patrick-groeppner/Track_your_cat_GPS-tracker/README.md

# Track_your_cat_GPS-tracker
project files for the development of a gps tracker for the offline movement tracking of your beloved home cat. Can also be used for other tracking purposes like car movement recordings or the measurement of walking routs
