patrick-groeppner/Track_your_cat_GPS-tracker/_Abschlussbericht Track-your-cat/Datenblatt des Produktes Track your Cat.pdf

## „Track your Cat“ - GPS-Empfänger

### 1 Merkmale

- Keine monatlichen Gebühren
- Kleine Dimensionierung
- Lange Batterielaufzeit
- Plug & Play
- Einfach zu verwendendes
Gerät
- Datenformat passend für
Google Earth
- Niedriges Gewicht
- Entlastend für Haustiere
- Gehäuse passend für gängige Halsbänder
- Micro-SD Karte
- günstiger Speicher

### 2 Aufbau

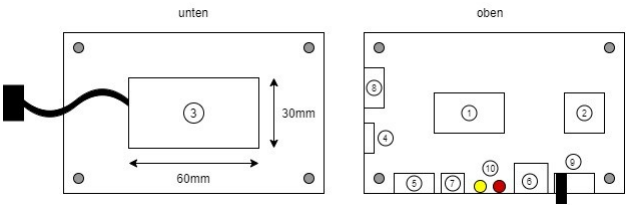
[picture p16: figure]

1: 8-bit Mikrokontroller
2: GPS Empfangschip
3: 3,7V Lithium Polymer Batterie 4: Thermistor Anschluss
5: Micro USB-Stecker

### 3 Beschreibung

Das „Track your Cat“ ist ein GPS-Empfangsgerät basierend auf einen 8-bit Mikrocontroller von Atmel mit wiederaufladbarem Akku. Als Receiver Chip wird der ORG1410 von OriginGPS verwendet. Es besteht aus einer kompakten Hauptplatine und ist in einem 3Dgedrucktes Gehäuse eingebaut. Die Empfangsantenne ist Innen im Gehäuse integriert und somit vor äußeren Umwelteinflüssen geschützt.

### 4 Anwendungen

- Haustiere verfolgen
- Eigenes Auto verfolgen
- Joggingstrecke verfolgen

6: Micro SD-Karten Stecker 7: Druckschalter
8: Anschluss Batterie
9: Stromschalter
10: Leuchtdioden

### 5 Block-Diagramm

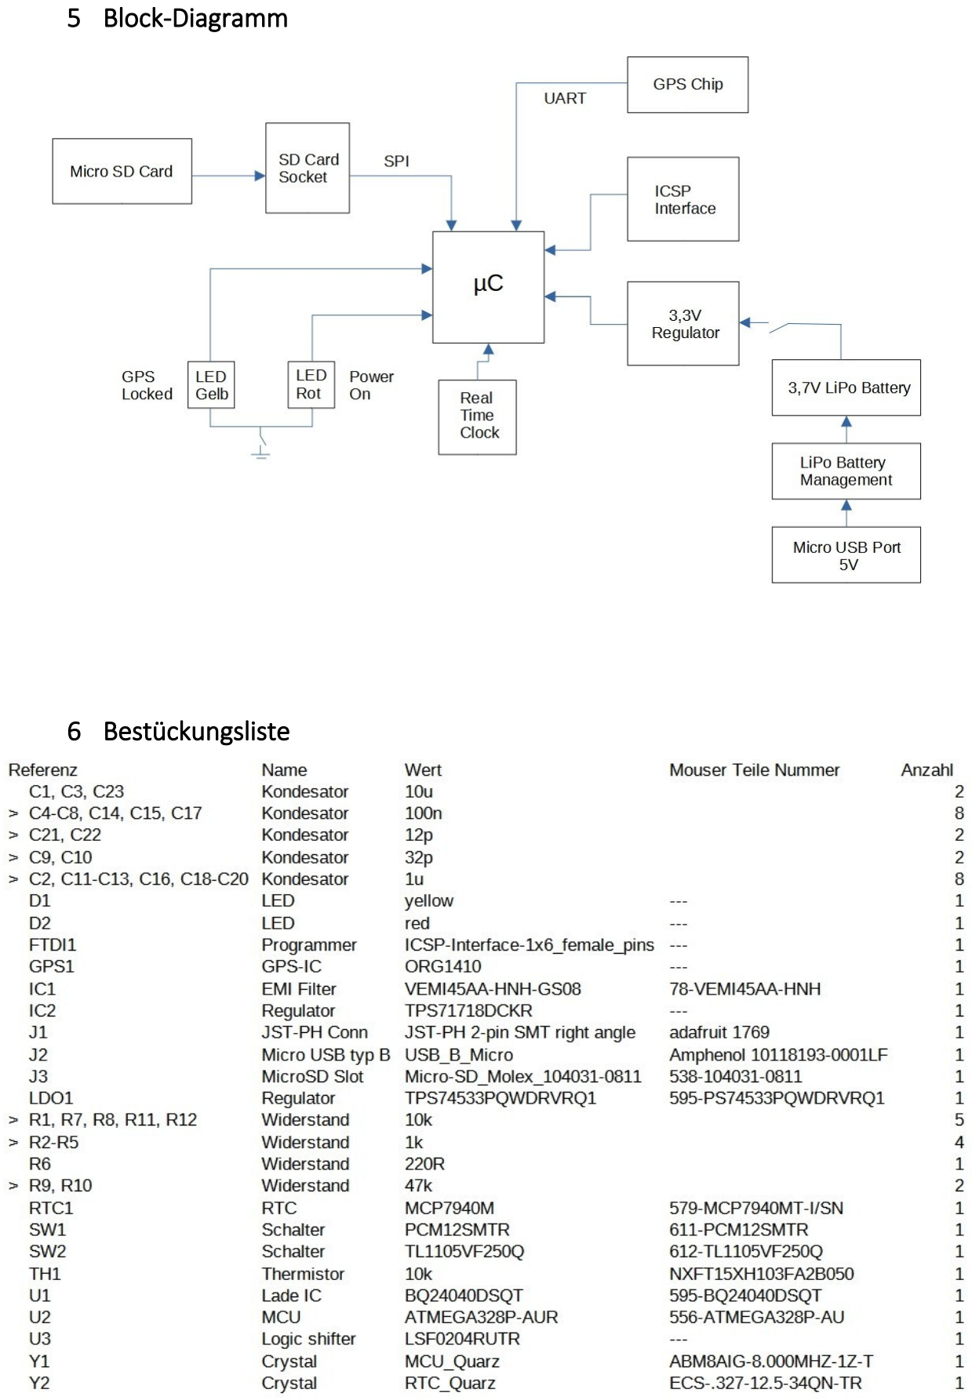
[picture p17: page 2]

### 6 Bestückungsliste
