patrick-groeppner/Track_your_cat_GPS-tracker/_Abschlussbericht Track-your-cat/bilder/blockdiagramm.jpg

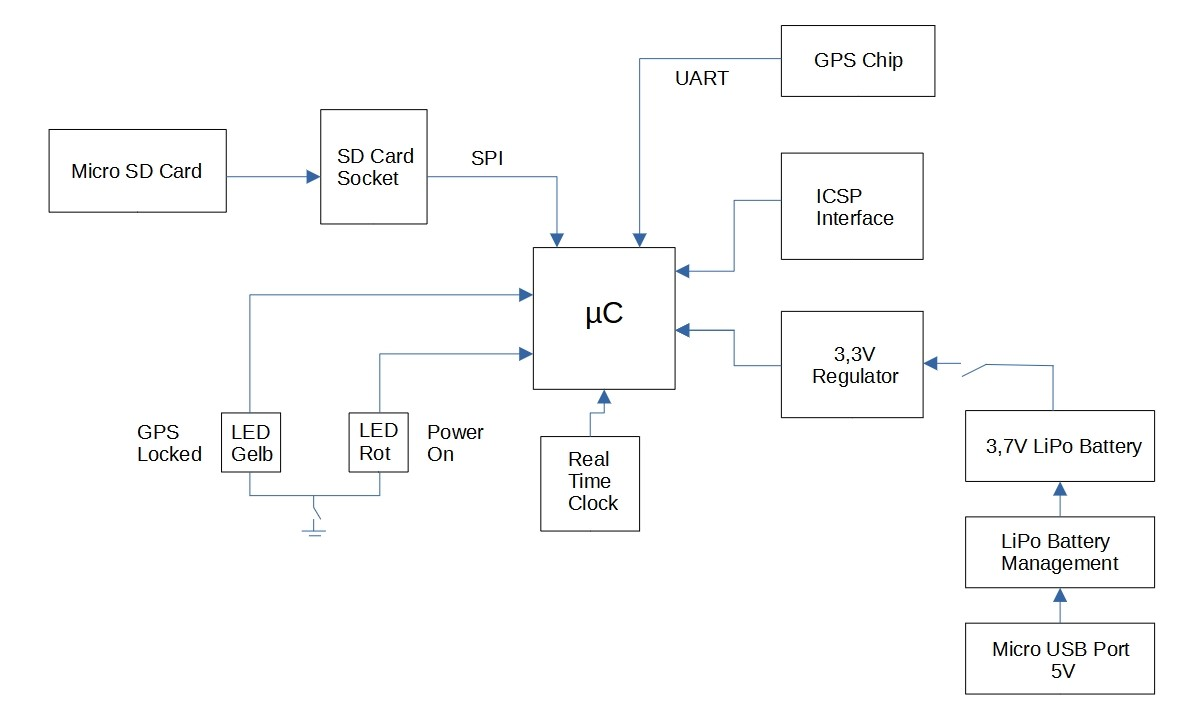
_Abschlussbericht Track-your-cat/bilder/blockdiagramm.jpg
