patrick-groeppner/Track_your_cat_GPS-tracker/_Abschlussbericht Track-your-cat/bilder/blockschaltbild.jpg

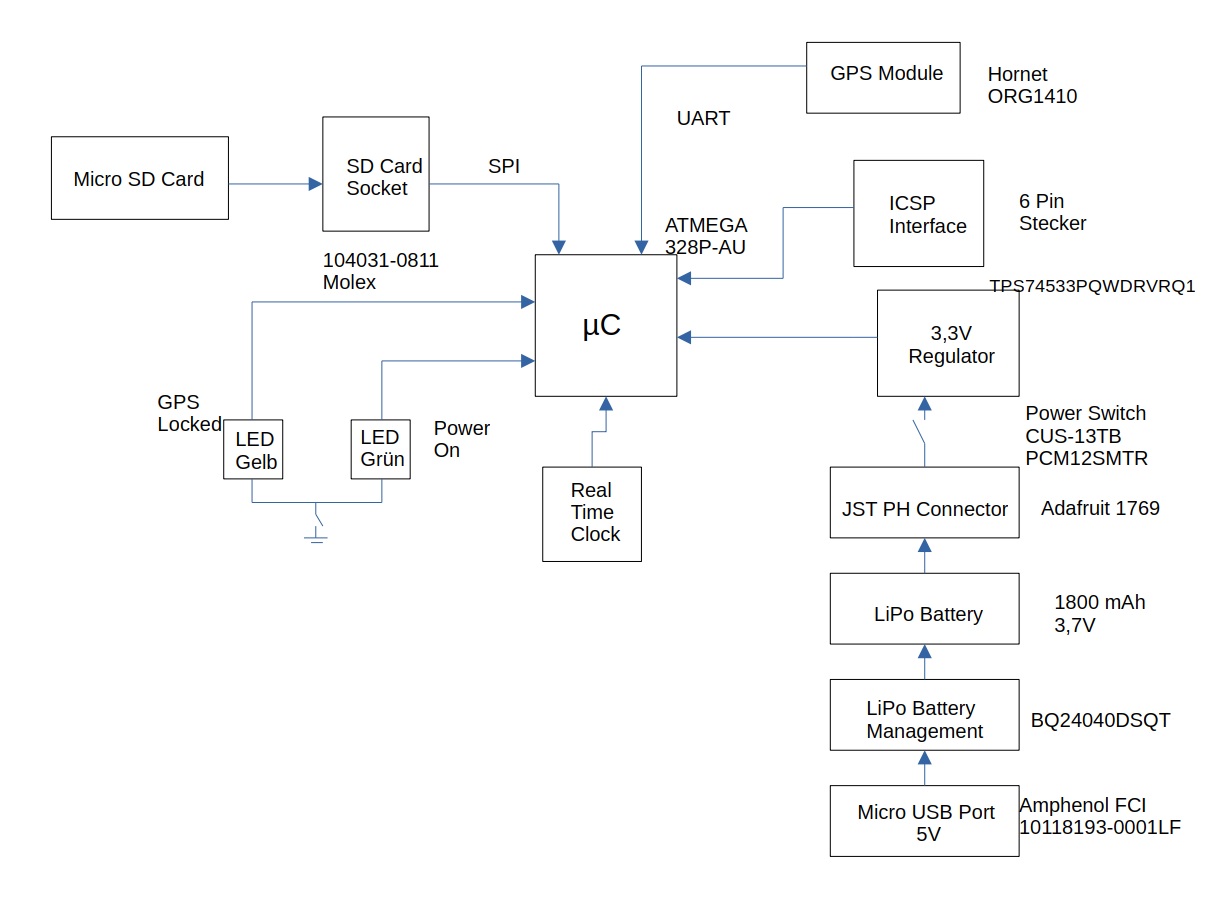
_Abschlussbericht Track-your-cat/bilder/blockschaltbild.jpg
