patrick-groeppner/Track_your_cat_GPS-tracker/_Abschlussbericht Track-your-cat/bilder/Programmablaufdiagramm-Beispiel.jpg

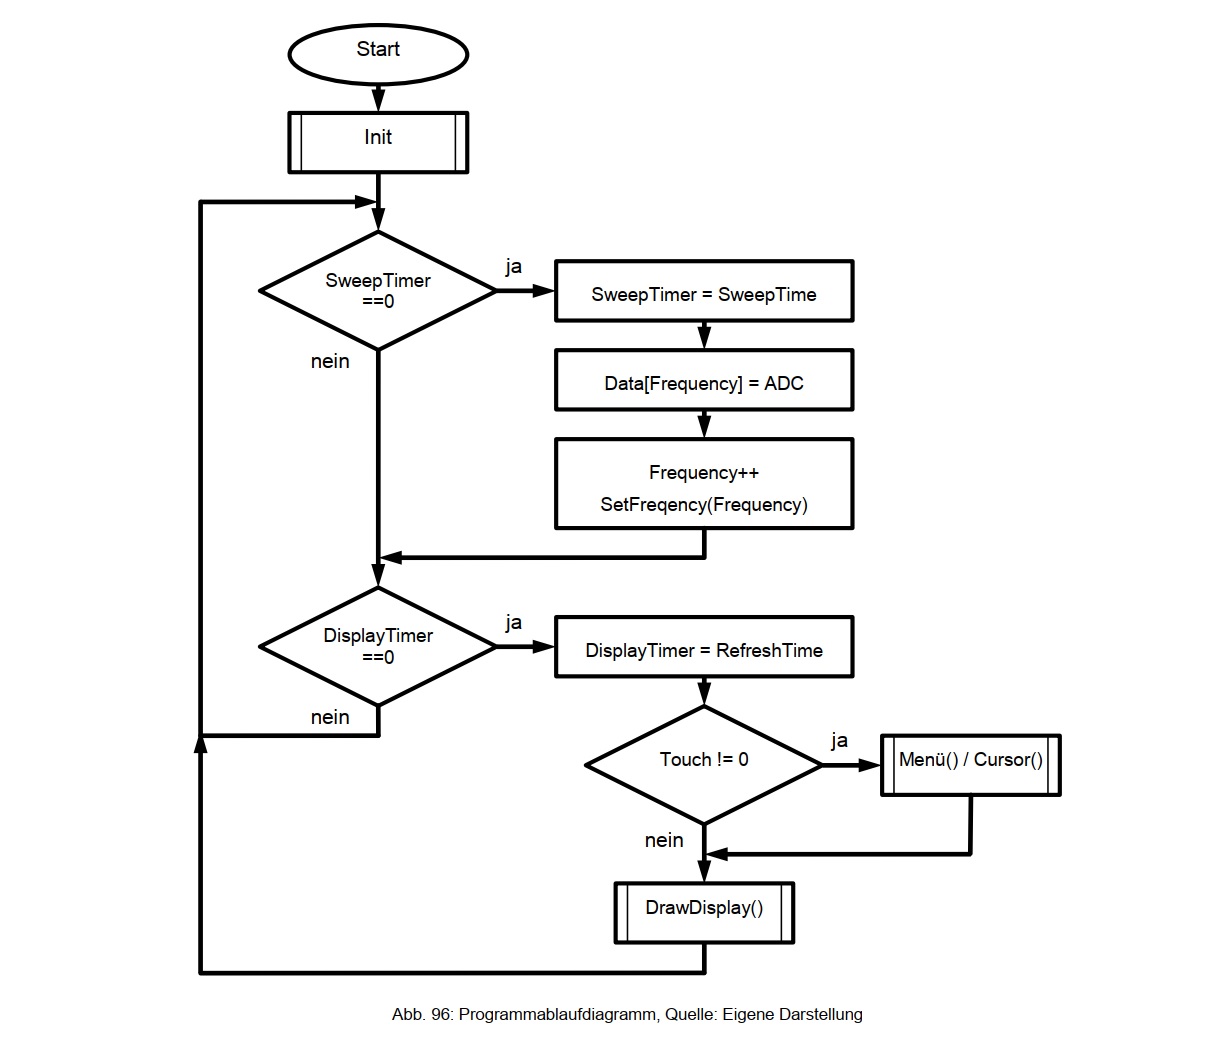
_Abschlussbericht Track-your-cat/bilder/Programmablaufdiagramm-Beispiel.jpg
