patrick-groeppner/Track_your_cat_GPS-tracker/docs/BOM-Track-your-cat.jpg

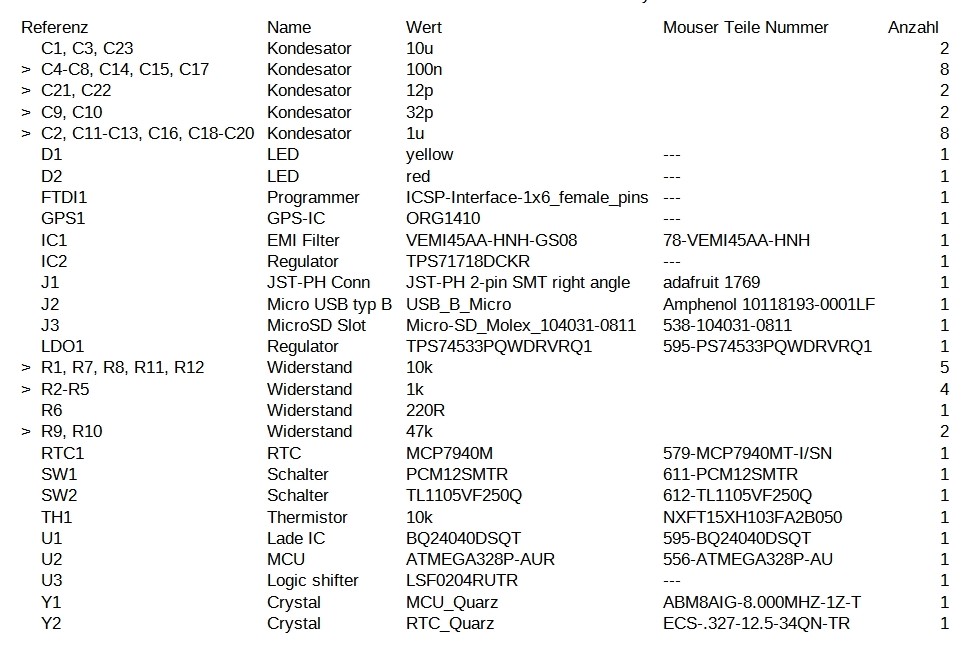
docs/BOM-Track-your-cat.jpg
