patrick-groeppner/Track_your_cat_GPS-tracker/step/gehäuse v5.step

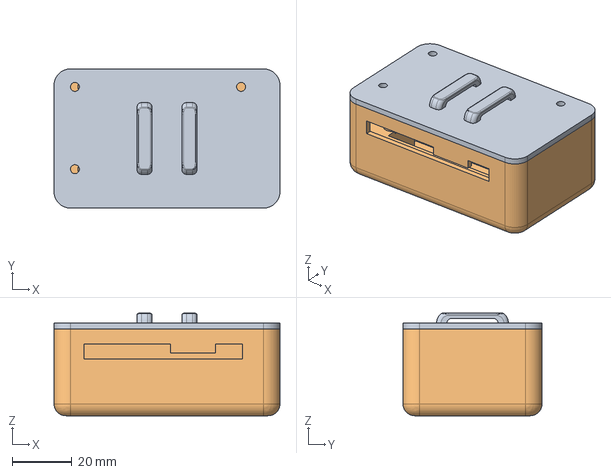
[picture p22: CAD file, 2025-05-05]
step/gehäuse v5.step
75.5 x 46.5 x 34.3 mm
