patrick-groeppner/Track_your_cat_GPS-tracker/step/stl/lid.stl

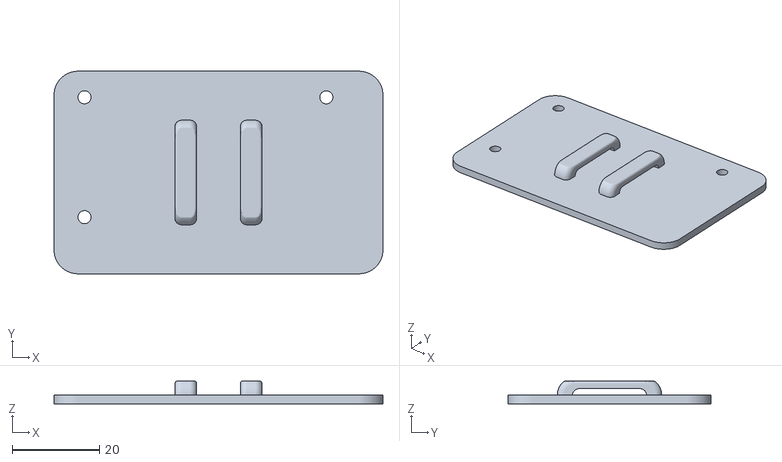
[picture p23: CAD file, 2025-05-05]
step/stl/lid.stl
75.5 x 46.5 x 5.25
