patrick-groeppner/Track_your_cat_GPS-tracker/step/stl/case.stl

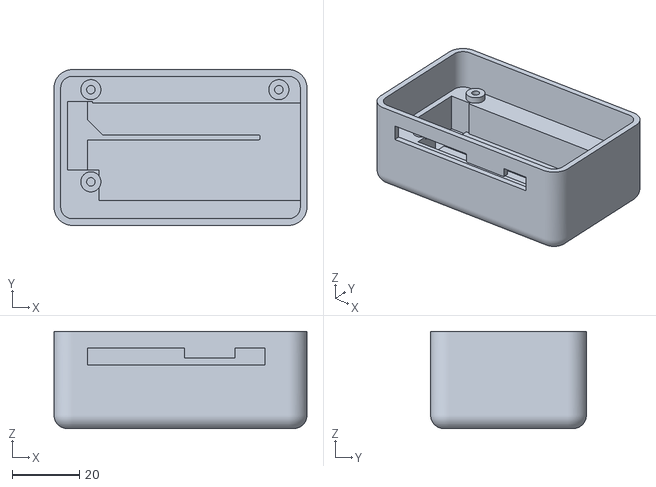
[picture p24: CAD file, 2025-05-05]
step/stl/case.stl
75.5 x 46.5 x 29.0
