patrick-groeppner/Track_your_cat_GPS-tracker/step/stl/stecker.stl

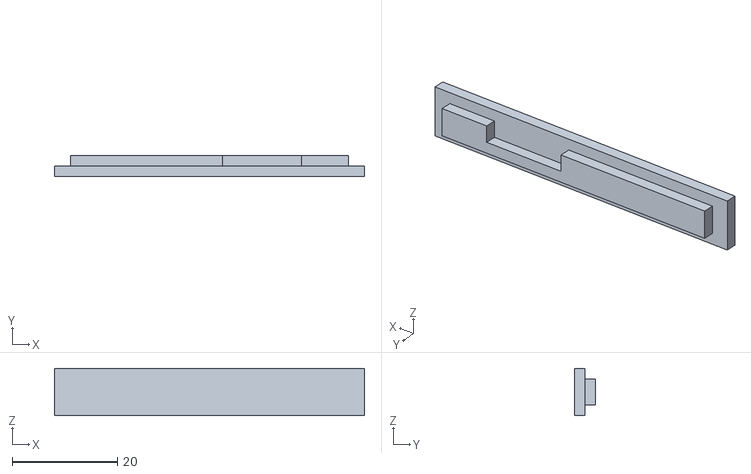
[picture p25: CAD file, 2025-05-05]
step/stl/stecker.stl
59.0 x 4.00 x 9.00
