patrick-groeppner/Track_your_cat_GPS-tracker/(list of files, cad)

Other CAD files:
step/gehäuse.f3d
