patrick-groeppner/Track_your_cat_GPS-tracker/_Abschlussbericht Track-your-cat/bilder/aufbauv2.jpg

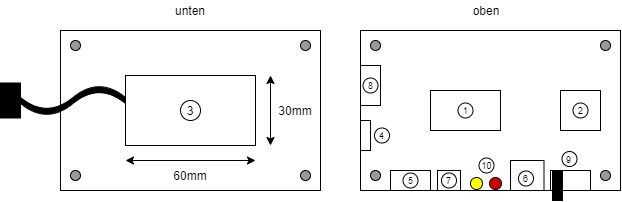
_Abschlussbericht Track-your-cat/bilder/aufbauv2.jpg
