patrick-groeppner/Track_your_cat_GPS-tracker/Track-your-cat.pdf

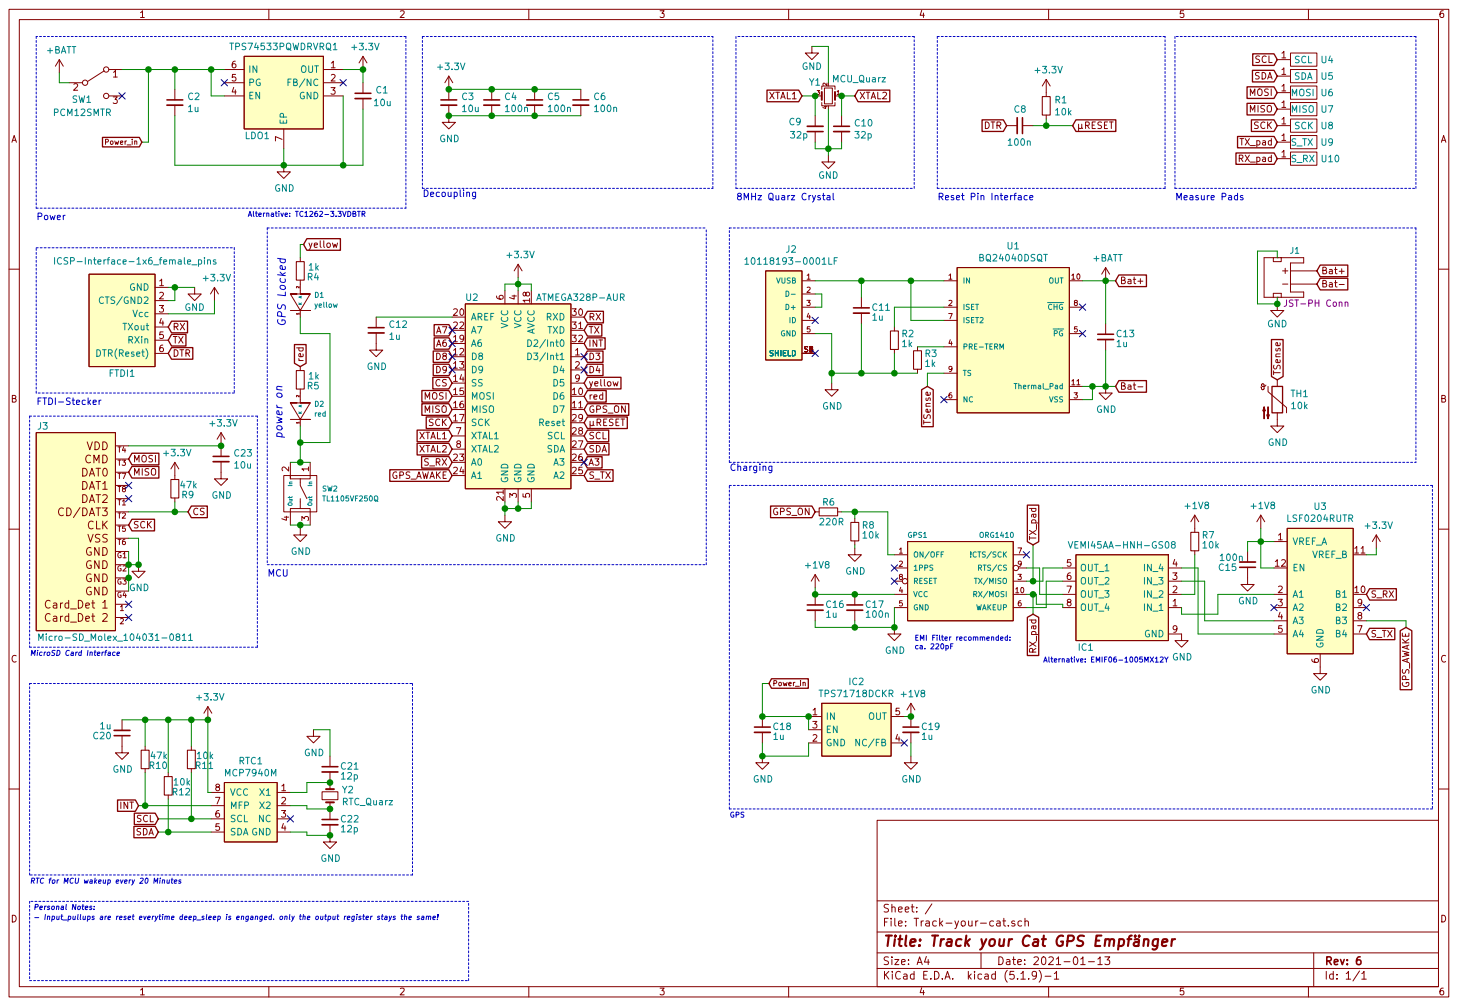
[picture p27: page 1]

FTDI-Stecker RTC for MCU wakeup every 20 Minutes

Card_Det 2 CD/DAT3 CLK CMD
DAT0 DAT1 DAT2 GND GND GND GND

File: Track-your-cat.sch Sheet: /
Id: 1/1 Title: Track your Cat GPS Empfänger
