patrick-groeppner/Track_your_cat_GPS-tracker/docs/Schaltplan-Track-your-cat.pdf

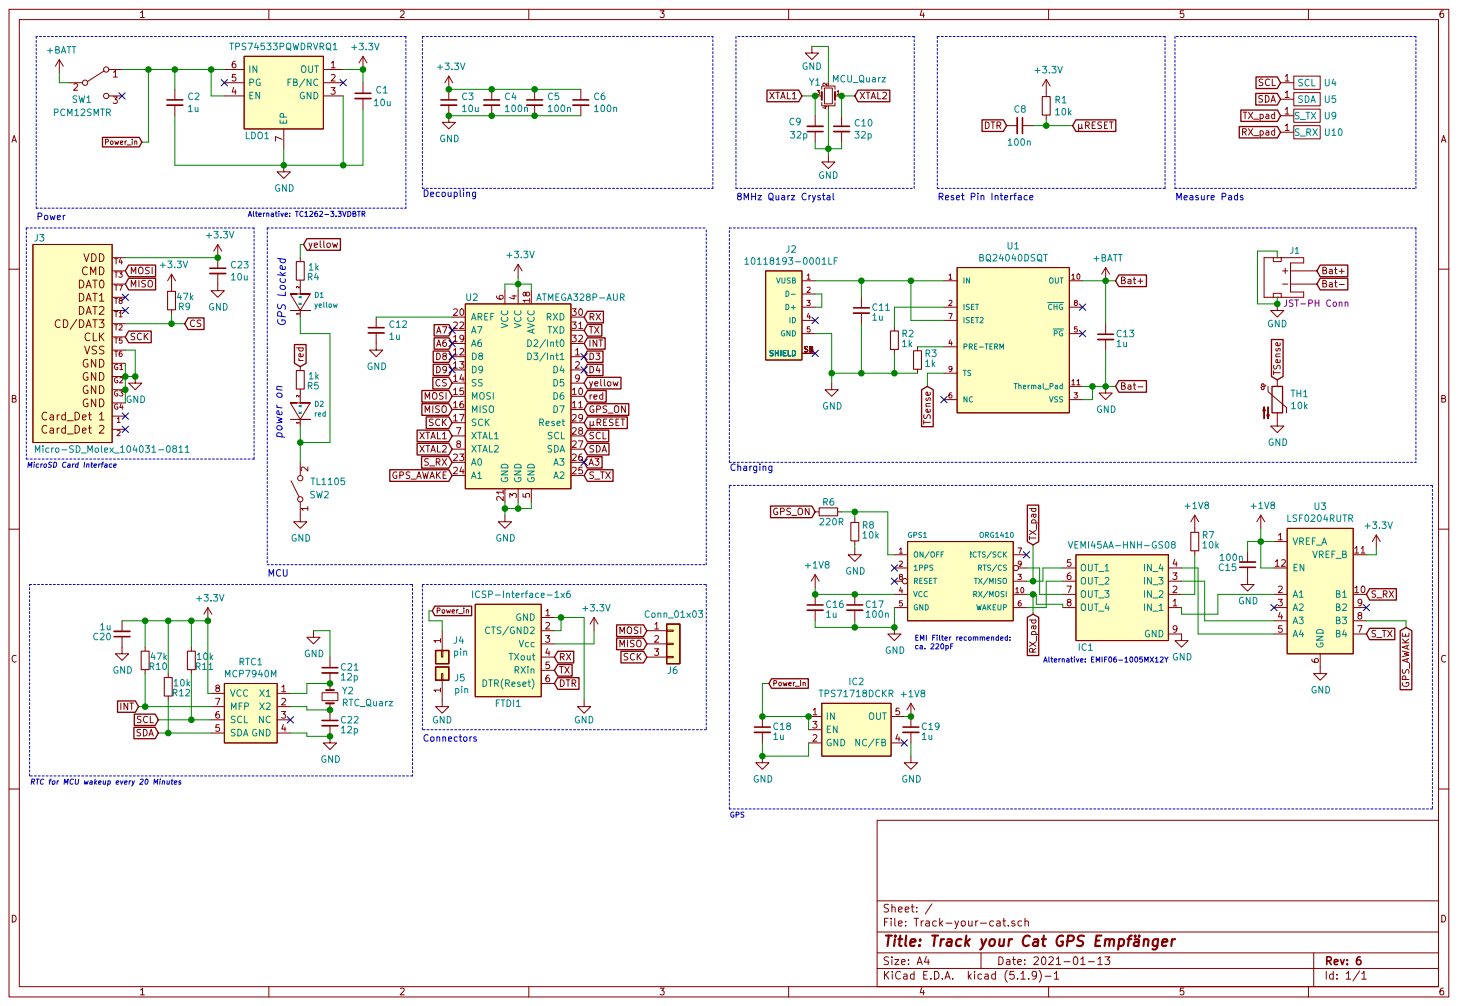
[picture p28: page 1]

+3.3V GND
Card_Det 2 CD/DAT3 CLK CMD
DAT0 DAT1 DAT2 GND GND GND GND
INT RX

EMI Filter recommended: ca. 220pF

RTC for MCU wakeup every 20 Minutes

File: Track-your-cat.sch Sheet: /
Id: 1/1 Title: Track your Cat GPS Empfänger
