patrick-groeppner/Track_your_cat_GPS-tracker/step/drawings/deckel.pdf

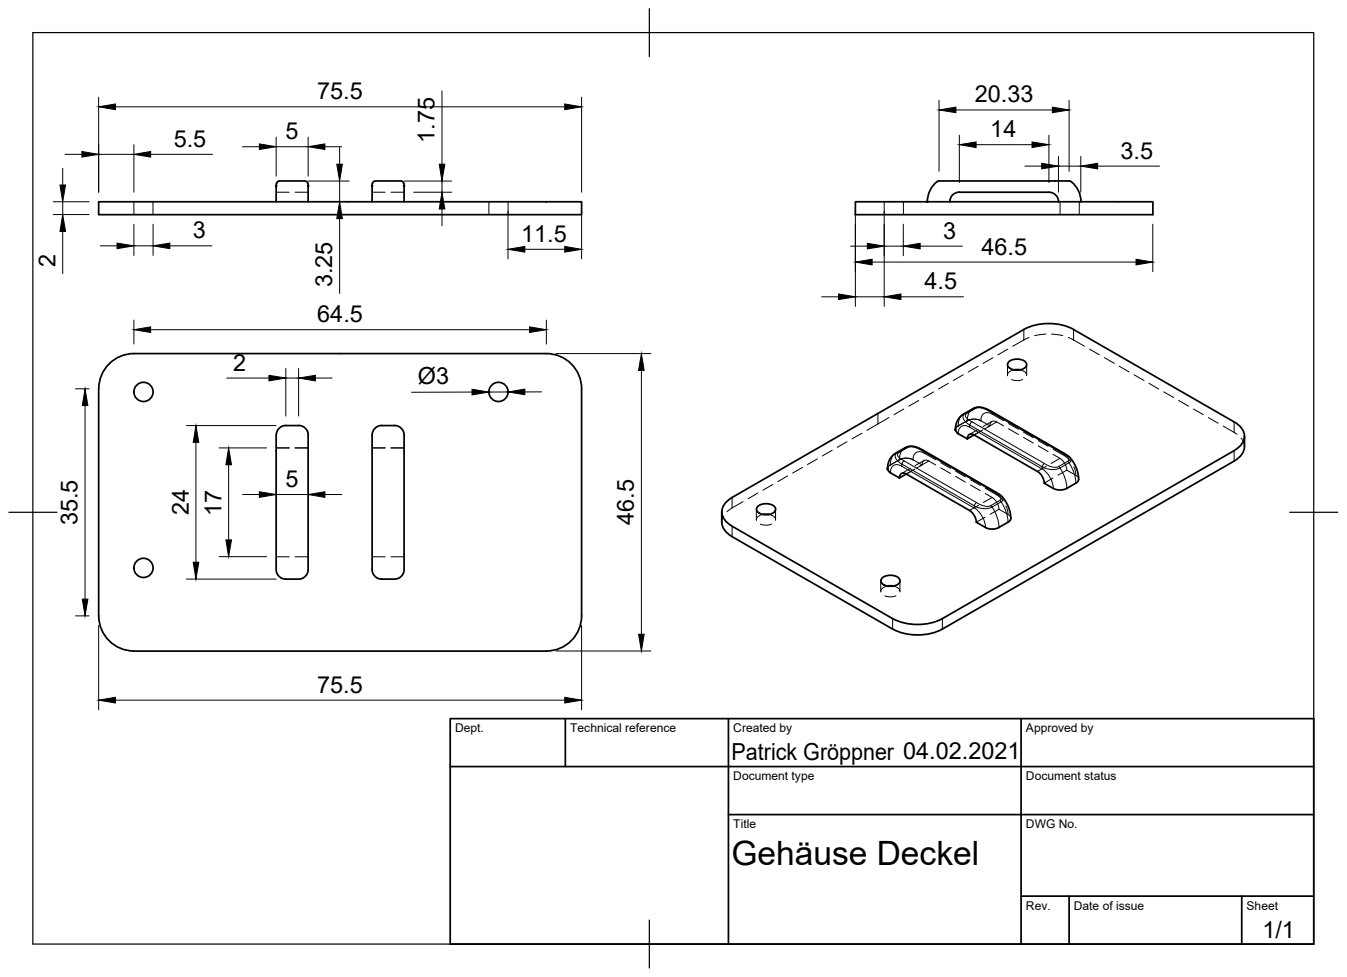
[picture p29: page 1]

Dept. | Technical reference | Created by Patrick Gröppner 04.02.2021 | Approved by

Document type | Document status

Title Gehäuse Deckel | DWG No.

Rev. | Date of issue | Sheet 1/1
