patrick-groeppner/Track_your_cat_GPS-tracker/Track-your-cat.kicad_pcb

## KiCad design Track-your-cat.kicad_pcb (2025-05-05)

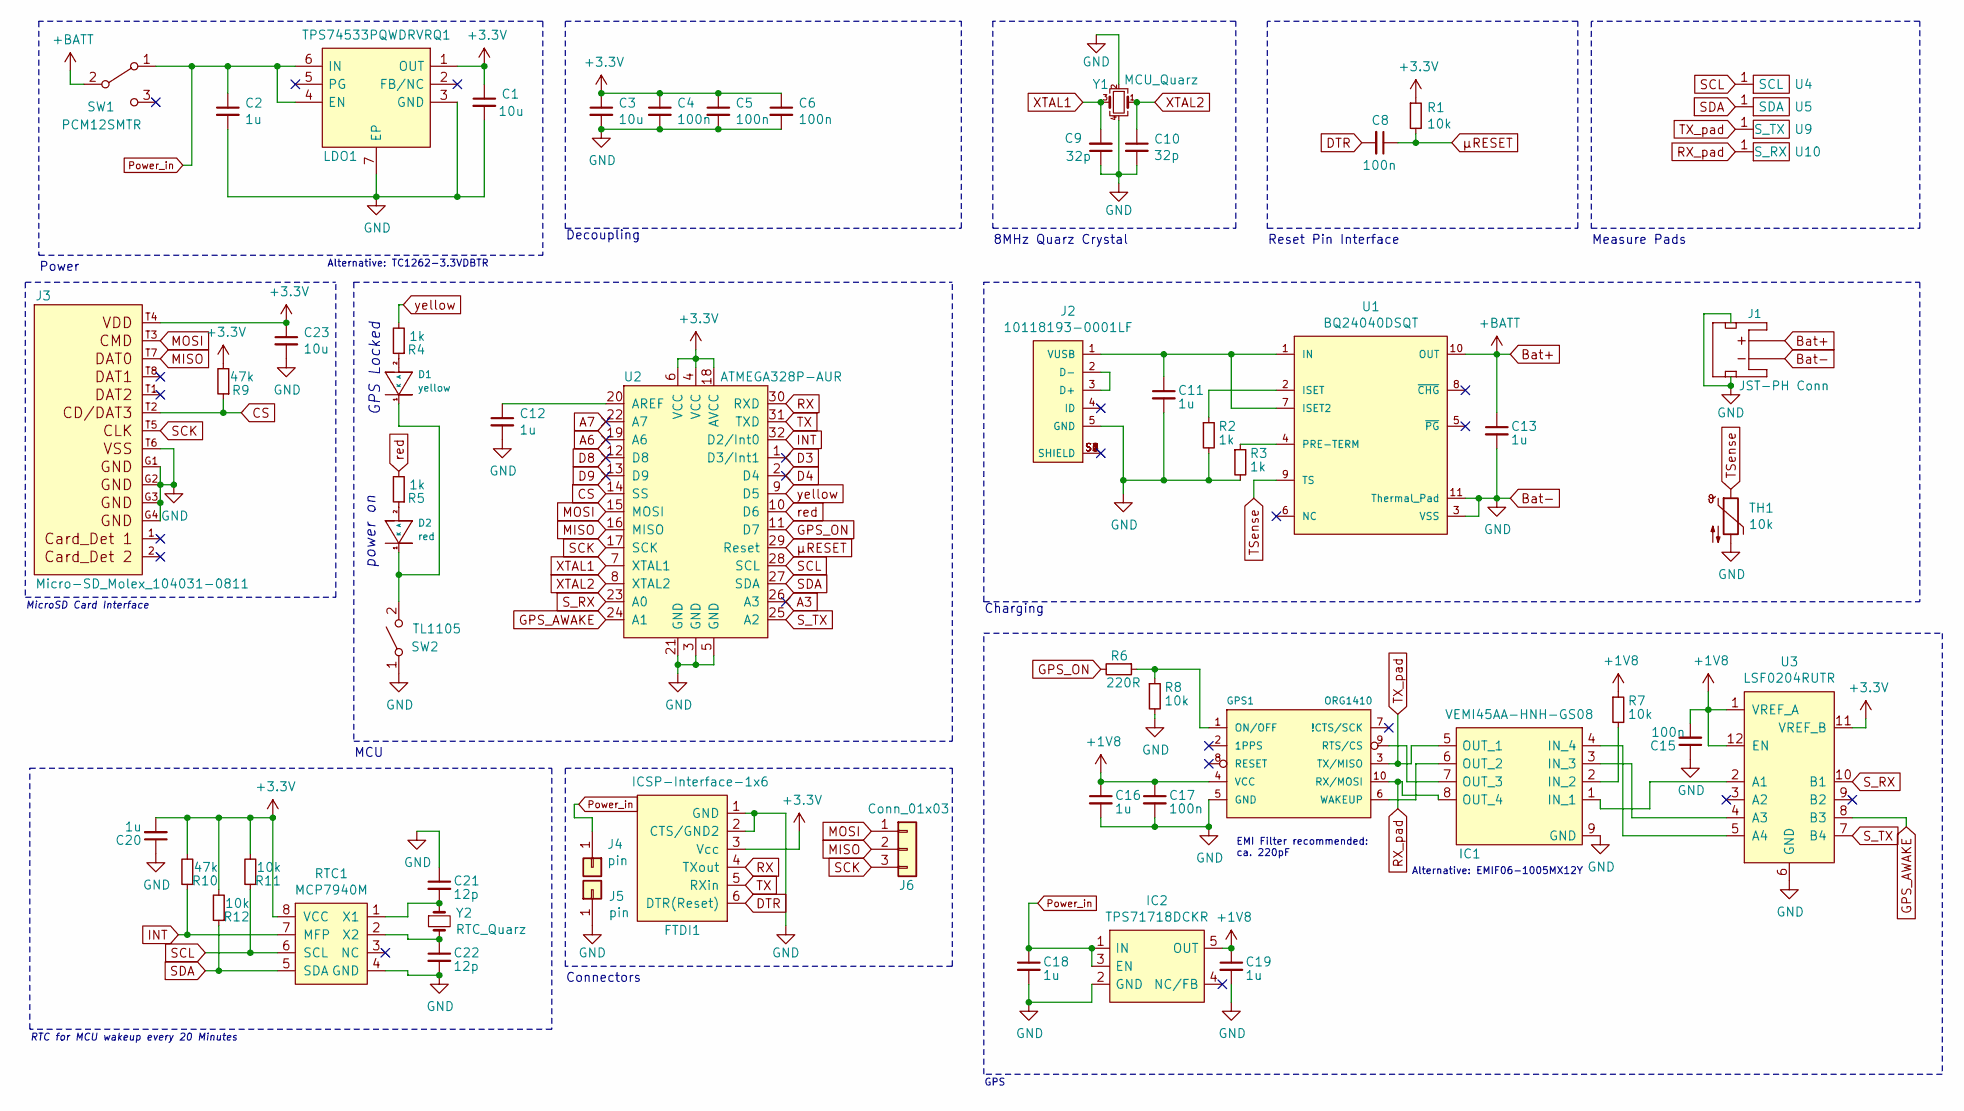
[picture p31: schematic Track-your-cat.sch, Track your Cat GPS Empfänger]

Parts:
C1, C3, C23: 10u; C_0805_2012Metric_Pad1.18x1.45mm_HandSolder
C2, C11, C12, C13, C16, C18, C19, C20: 1u; C_0603_1608Metric_Pad1.08x0.95mm_HandSolder
C4, C5, C6, C8, C15, C17: 100n; C_0603_1608Metric_Pad1.08x0.95mm_HandSolder
C9, C10: 32p; C_0603_1608Metric_Pad1.08x0.95mm_HandSolder
C21, C22: 12p; C_0603_1608Metric_Pad1.08x0.95mm_HandSolder
D1: yellow; LED_3MM
D2: red; LED_3MM
FTDI1: ICSP-Interface-1x6; ICSP1; Mouser Part Number ---
GPS1: ORG1410; Mouser Part Number ---
IC1: VEMI45AA-HNH-GS08; Manufacturer_Part_Number VEMI45AA-HNH-GS08; Mouser Part Number 78-VEMI45AA-HNH
IC2: TPS71718DCKR; SC70; Manufacturer_Part_Number TPS71718DCKR; Mouser Part Number 595-TPS71718DCKR
J1: JST_2MM_MALE; JST-2-SMD; Mouser Part Number adafruit 1769
J2: 10118193-0001LF; FCI_10118193-0001LF
J3: Micro-SD_Molex_104031-0811; Micro-SD-Card-Molex_104031-0811; current rating 0.5A; voltage rating 10V; Mouser Part Number 538-104031-0811; digikey description CONN MICRO SD CARD PUSH-PULL R/A
J4, J5: pin; PinHeader_1x01_P2.54mm_Vertical
J6: Conn_01x03; PinHeader_1x03_P2.54mm_Vertical
LDO1: TPS74533PQWDRVRQ1; Manufacturer_Part_Number TPS74533PQWDRVRQ1; Mouser Part Number 595-PS74533PQWDRVRQ1
R1, R7, R8, R11, R12: 10k; R_0603_1608Metric_Pad0.98x0.95mm_HandSolder
R2, R3, R4, R5: 1k; R_0603_1608Metric_Pad0.98x0.95mm_HandSolder
R6: 220R; R_0603_1608Metric_Pad0.98x0.95mm_HandSolder
R9, R10: 47k; R_0603_1608Metric_Pad0.98x0.95mm_HandSolder
RTC1: MCP7940M; SOIC-8_W3.9mm; Mouser Part Nbr. 579-MCP7940MT-I/SN
SW1: PCM12SMTR; Mouser Part Number CUS-13TB PCM12SMTR
SW2: TL1105; TL1105VF250Q
TH1: 10k; THERM_NXRT15XH103FA1B040; Mouser Part Nbr. NXFT15XH103FA2B050
U1: BQ24040DSQT; Texas_Instruments-DSQ0010A-0-0-IPC_C; output voltage 4.2V; Mouser Part Number 595-BQ24040DSQT; digikey description IC BATT CHG LI-ION 1 CELL 10SON
U2: ATMEGA328P-AUR; TQFP-32_7x7mm; MPN ATMEGA328P-AUR; Digi-Key_PN ATMEGA328P-AURCT-ND
U3: LSF0204RUTR; IC_LSF0204RUTR; PARTREV 4210580/C 06/12
U4: SCL; Single0805pad
U5: SDA; Single0805pad
U9: S_TX; Single0805pad
U10: S_RX; Single0805pad
Y1: MCU_Quarz; Crystal_SMD_3225-4Pin_3.2x2.5mm_HandSoldering; Mouser Part Number ABM8AIG-8.000MHZ-1Z-T
Y2: RTC_Quarz; XTAL_ECS-.327-12.5-34QN-TR; Mouser Part Nbr. 732-MC30632.7680KA0R

Connections:
+1V8: C15.2, C16.1, C17.1, C19.1, GPS1.4 (VCC), IC2.5 (OUT), R7.1, U3.1 (VREF_A), U3.12 (EN)
+3V3: C1.1, C3.1, C4.1, C5.1, C6.1, C20.2, C23.1, FTDI1.3 (Vcc), J3.T4, LDO1.1 (OUT), R1.1, R9.2, R10.2, R11.2, R12.2, RTC1.8 (VCC), U2.4 (VCC), U2.6 (VCC), U2.18 (AVCC), U3.11 (VREF_B)
A3: U2.26 (A3)
A6: U2.19 (A6)
A7: U2.22 (A7)
Bat+: C13.1, J1.2 (+), SW1.2 (B), U1.10 (OUT)
Bat-: C1.2, C2.2, C3.2, C4.2, C5.2, C6.2, C9.1, C10.2, C11.2, C12.2, C13.2, C15.1, C16.2, C17.2, C18.2, C19.2, C20.1, C21.1, C22.2, C23.2, FTDI1.1 (GND), FTDI1.2 (CTS/GND2), GPS1.5 (GND), IC1.9 (GND), IC2.2 (GND), J1.1 (-), J1.NC1 (PAD1), J1.NC2 (PAD2), J2.5 (GND), J3.G1, J3.G2, J3.G3, J3.G4, J3.T6, J5.1, LDO1.3 (GND), LDO1.7 (EP), R2.2, R3.2, R8.2, RTC1.4 (GND), SW2.1 (A), TH1.2, U1.3 (VSS), U1.11 (Thermal_Pad), U2.3 (GND), U2.5 (GND), U2.21 (GND), U3.6 (GND), Y1.2, Y1.4
CS: J3.T2, R9.1, U2.14 (SS)
D3: U2.1 (D3/Int1)
D4: U2.2 (D4)
D8: U2.12 (D8)
D9: U2.13 (D9)
DTR: C8.2, FTDI1.6 (DTR(Reset))
GPS_AWAKE: U2.24 (A1), U3.8 (B3)
GPS_ON: R6.2, U2.11 (D7)
INT: R10.1, RTC1.7 (MFP), U2.32 (D2/Int0)
MISO: J3.T7, J6.2, U2.16 (MISO)
MOSI: J3.T3, J6.1, U2.15 (MOSI)
unnamed: C11.1, J2.1 (VUSB), U1.1 (IN), U1.7 (ISET2)
unnamed: C12.1, U2.20 (AREF)
unnamed: C21.2, RTC1.1 (X1), Y2.1
unnamed: C22.1, RTC1.2 (X2), Y2.2
unnamed: D1.1 (K), D2.1 (K), SW2.2 (B)
unnamed: D1.2 (A), R4.1
unnamed: D2.2 (A), R5.1
unnamed: GPS1.1 (ON/OFF), R6.1, R8.1
unnamed: GPS1.6 (WAKEUP), IC1.6 (OUT_2)
unnamed: GPS1.9 (RTS/CS), IC1.7 (OUT_3)
unnamed: IC1.1 (IN_1), U3.2 (A1)
unnamed: IC1.2 (IN_2), R7.2
unnamed: IC1.3 (IN_3), U3.4 (A3)
unnamed: IC1.4 (IN_4), U3.5 (A4)
unnamed: J2.2 (D-), J2.3 (D+)
unnamed: J2.S1 (SHIELD), J2.S2 (SHIELD), J2.S3 (SHIELD), J2.S4 (SHIELD), J2.S5 (SHIELD), J2.S6 (SHIELD)
unnamed: R2.1, U1.2 (ISET)
unnamed: R3.1, U1.4 (PRE-TERM)
Power_in: C2.1, C18.1, IC2.1 (IN), IC2.3 (EN), J4.1, LDO1.4 (EN), LDO1.6 (IN), SW1.1 (A)
RX: FTDI1.4 (TXout), U2.30 (RXD)
RX_pad: GPS1.10 (RX/MOSI), IC1.8 (OUT_4), U10.1
SCK: J3.T5, J6.3, U2.17 (SCK)
SCL: R11.1, RTC1.6 (SCL), U2.28 (SCL), U4.1
SDA: R12.1, RTC1.5 (SDA), U2.27 (SDA), U5.1
S_RX: U2.23 (A0), U3.10 (B1)
S_TX: U2.25 (A2), U3.7 (B4)
TSense: TH1.1, U1.9 (TS)
TX: FTDI1.5 (RXin), U2.31 (TXD)
TX_pad: GPS1.3 (TX/MISO), IC1.5 (OUT_1), U9.1
XTAL1: C9.2, U2.7 (XTAL1), Y1.3
XTAL2: C10.1, U2.8 (XTAL2), Y1.1
red: R5.2, U2.10 (D6)
yellow: R4.2, U2.9 (D5)
µRESET: C8.1, R1.2, U2.29 (Reset)

Notes on the sheet:
Connectors
Power
Decoupling
8MHz Quarz Crystal
Reset Pin Interface
Charging
power on
GPS Locked
MicroSD Card Interface
GPS
MCU
Alternative: EMIF06-1005MX12Y
EMI Filter recommended: ca. 220pF
RTC for MCU wakeup every 20 Minutes
Measure Pads
Alternative: TC1262-3.3VDBTR

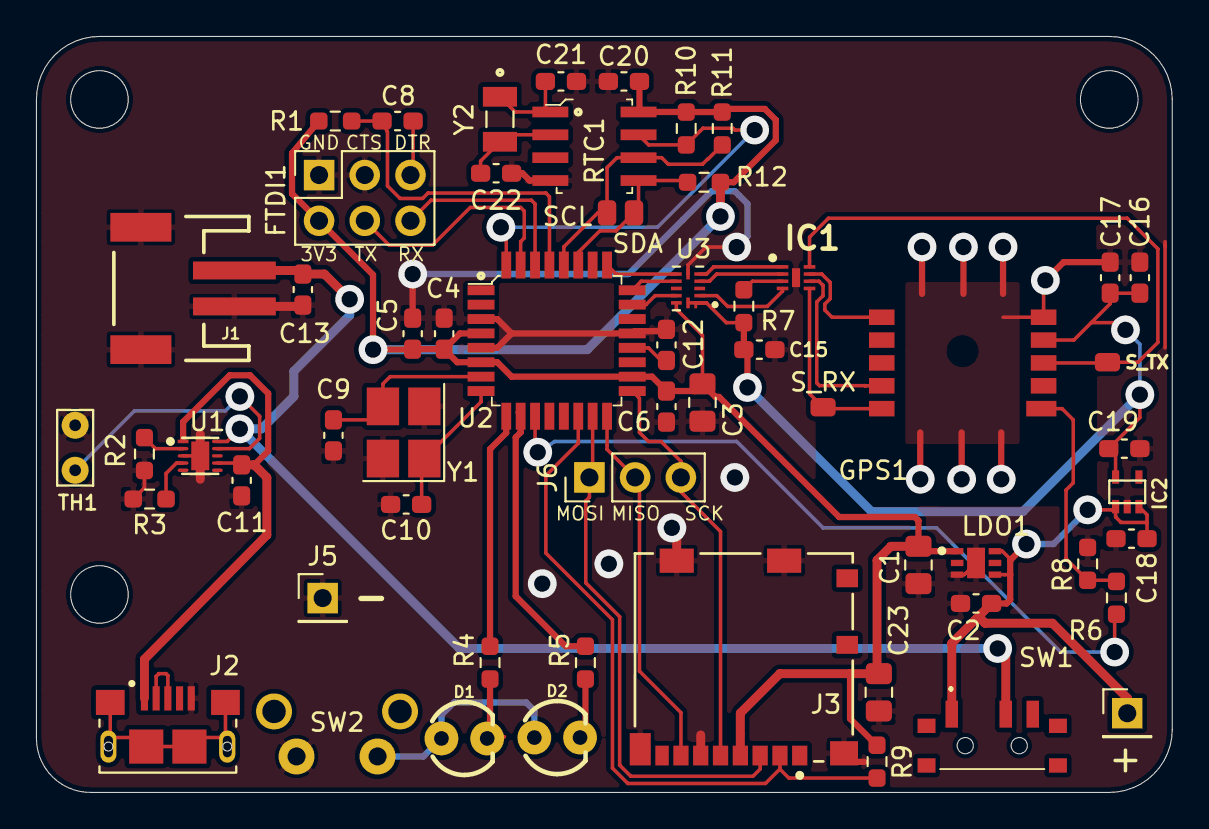
[picture p32: board Track-your-cat.kicad_pcb from above]

Board: 2 copper layers, 63.1 x 42.0 mm, 62 parts (0 on the bottom side), 45 nets.

Other parts of the board:
H1, H1#2, H1#3: MountingHole_3.2mm_M3
